javifercep/Krakoski/(threads)

Thread 1 (2015-12-20):

Correct USB connector footprint pinout

javifercep, 2015-12-20:
It is inverted

Thread 2 (2015-12-22):

Error in Arduino pinout footprint

javifercep, 2015-12-22:
The "ISP" connector is shifted 2,54 mm

Thread 3 (2015-12-22):

NRF024L01 footprint is inverted

javifercep, 2015-12-22:

Thread 4 (2015-12-28):

UART pins are inverted in schematic

javifercep, 2015-12-28:
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
