javifercep/Krakoski/Krakoski.kicad_pcb

## KiCad design Krakoski.kicad_pcb (2015-12-08)

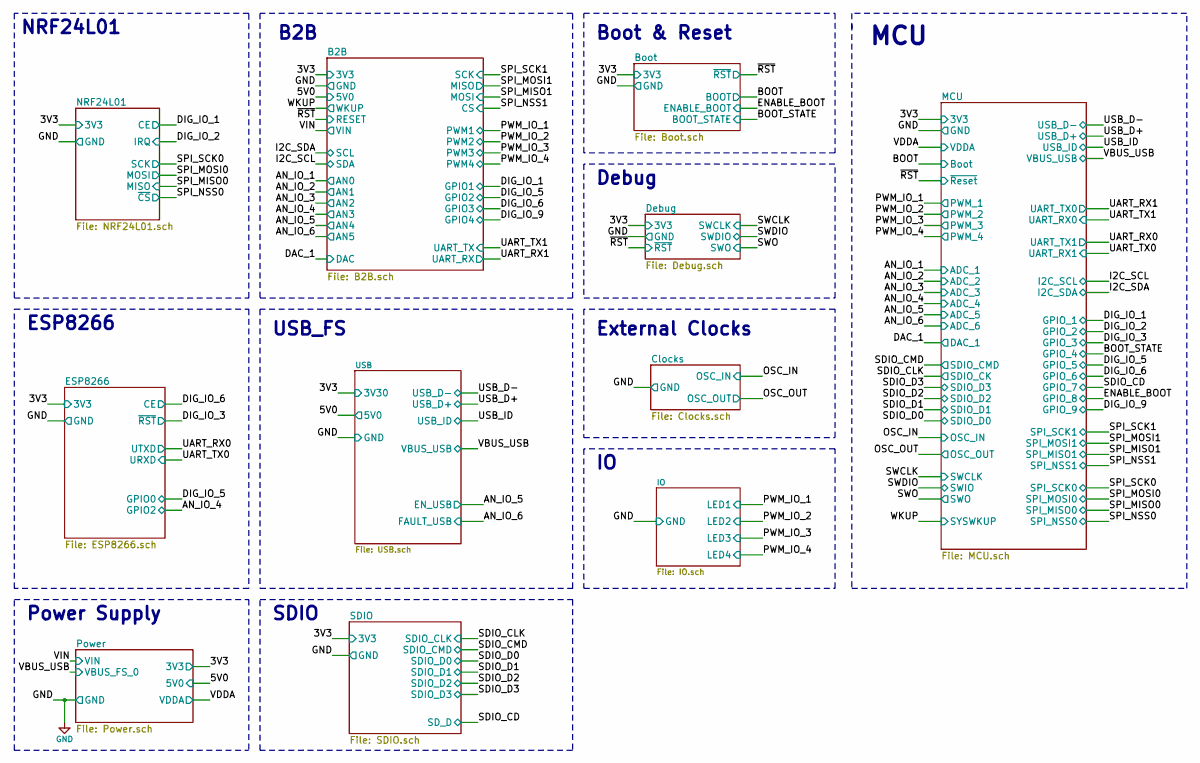
[picture p22: schematic Krakoski.sch]

Notes on the sheet:
Power Supply
USB_FS
Debug
External Clocks
MCU
Boot & Reset
ESP8266
B2B
NRF24L01
SDIO

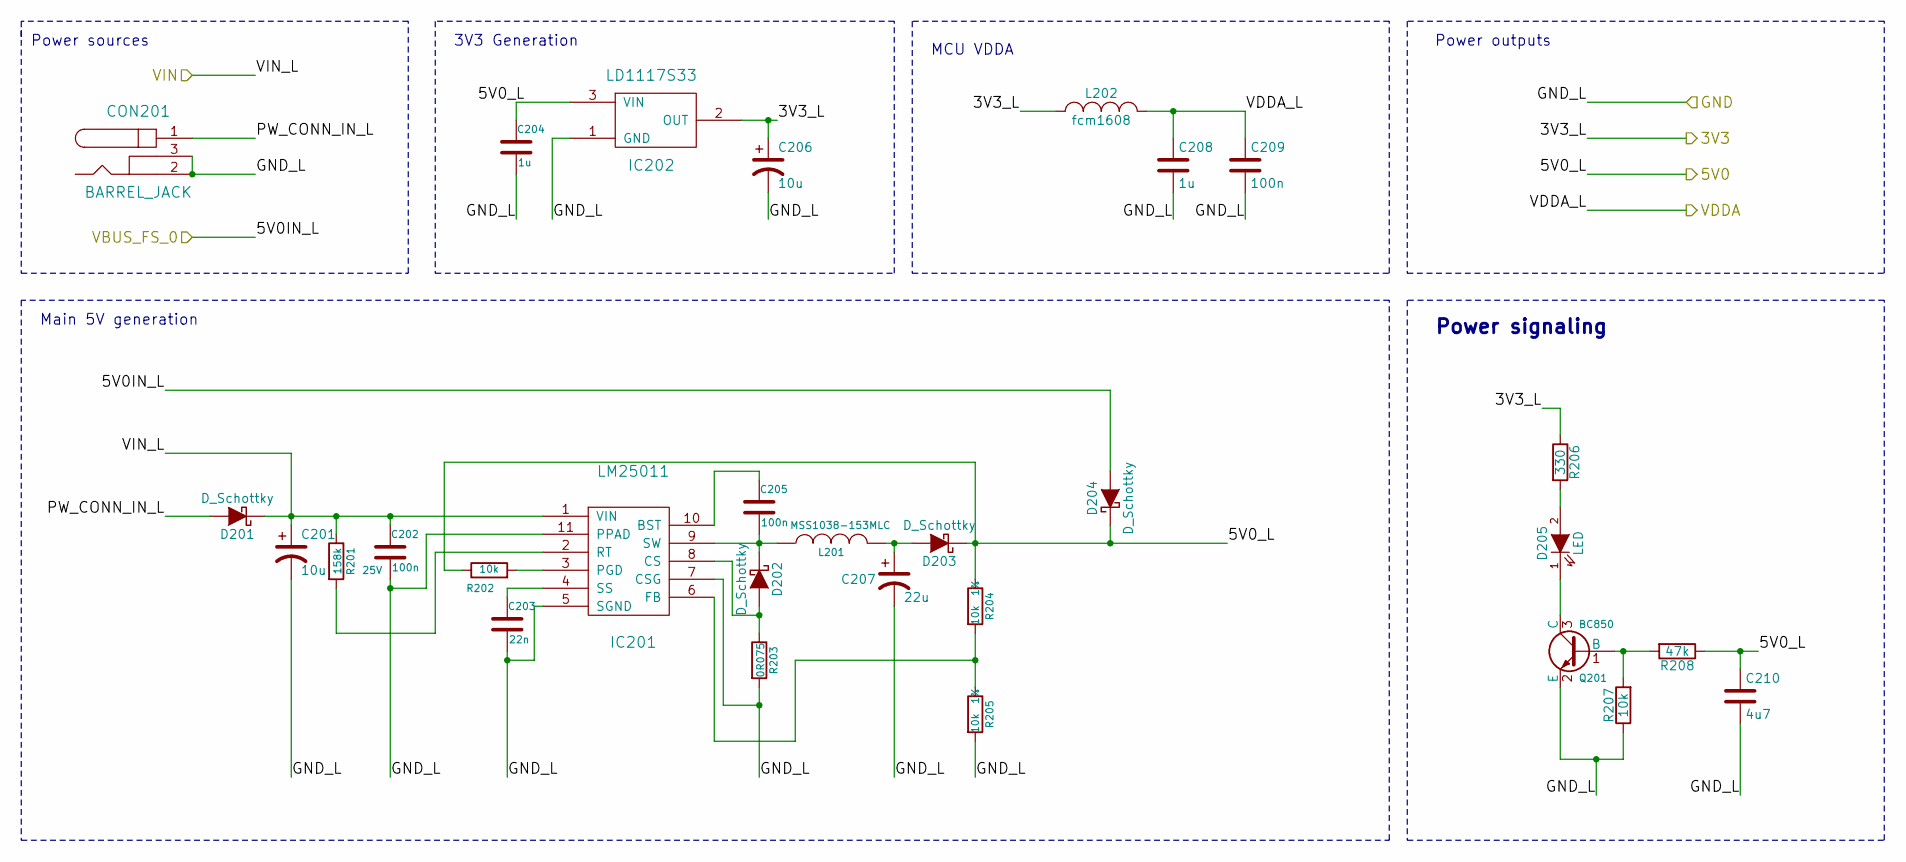
[picture p23: schematic Power.sch, Krakoski]

Parts:
C201: 10u; C_1206_HandSoldering
C202, C205: 100n; C_0805_HandSoldering
C203: 22n; C_0603_HandSoldering
C204, C208: 1u; C_0603_HandSoldering
C206: 10u; C_0603_HandSoldering
C207: 22u; C_1206_HandSoldering
C209: 100n; C_0603_HandSoldering
C210: 4u7; C_0805_HandSoldering
CON201: BARREL_JACK; JACK_ALIM_MOD
D201, D202, D203: D_Schottky; SMA_Handsoldering
D204: D_Schottky; SOD-123
D205: LED; LED-0805
IC201: LM25011; VSSOP10
IC202: LD1117S33; SOT-223
L201: MSS1038-153MLC; MSS1038
L202: fcm1608; R_0603_HandSoldering
Q201: BC850; SOT-23_Handsoldering
R201: 158k; R_0603_HandSoldering
R202, R207: 10k; R_0603_HandSoldering
R203: 0R075; R_0805_HandSoldering
R204, R205: 10k; R_0603_HandSoldering; Tolerancia 1%
R206: 330; R_0603_HandSoldering
R208: 47k; R_0603_HandSoldering

Connections:
/B2B/3V3: C206.1, IC202.2 (OUT), L202.1, R206.1; also elsewhere on the board
/B2B/5V0: C204.1, C210.1, D203.1 (K), D204.1 (K), IC202.3 (VIN), R202.1, R204.1, R208.1; also elsewhere on the board
/B2B/VIN: C201.1, C202.1, D201.1 (K), IC201.1 (VIN), R201.1; also elsewhere on the board
/MCU/VDDA: C208.1, C209.1, L202.2; also elsewhere on the board
/Power/PW_CONN_IN_L: CON201.1, D201.2 (A)
/Power/VBUS_FS_0: D204.2 (A); also elsewhere on the board
GND: C201.2, C202.2, C203.2, C204.2, C206.2, C207.2, C208.2, C209.2, C210.2, CON201.2, CON201.3, IC201.5 (SGND), IC201.7 (CSG), IC201.11 (PPAD), IC202.1 (GND), Q201.2 (E), R203.2, R205.2, R207.1; also elsewhere on the board
unnamed: C203.1, IC201.4 (SS)
unnamed: C205.1, IC201.10 (BST)
unnamed: C205.2, D202.1 (K), IC201.9 (SW), L201.1
unnamed: C207.1, D203.2 (A), L201.2
unnamed: D202.2 (A), IC201.8 (CS), R203.1
unnamed: D205.1 (K), Q201.3 (C)
unnamed: D205.2 (A), R206.2
unnamed: IC201.2 (RT), R201.2
unnamed: IC201.3 (PGD), R202.2
unnamed: IC201.6 (FB), R204.2, R205.1
unnamed: Q201.1 (B), R207.2, R208.2

Notes on the sheet:
Power sources
Main 5V generation
3V3 Generation
Power outputs
Power signaling
MCU VDDA

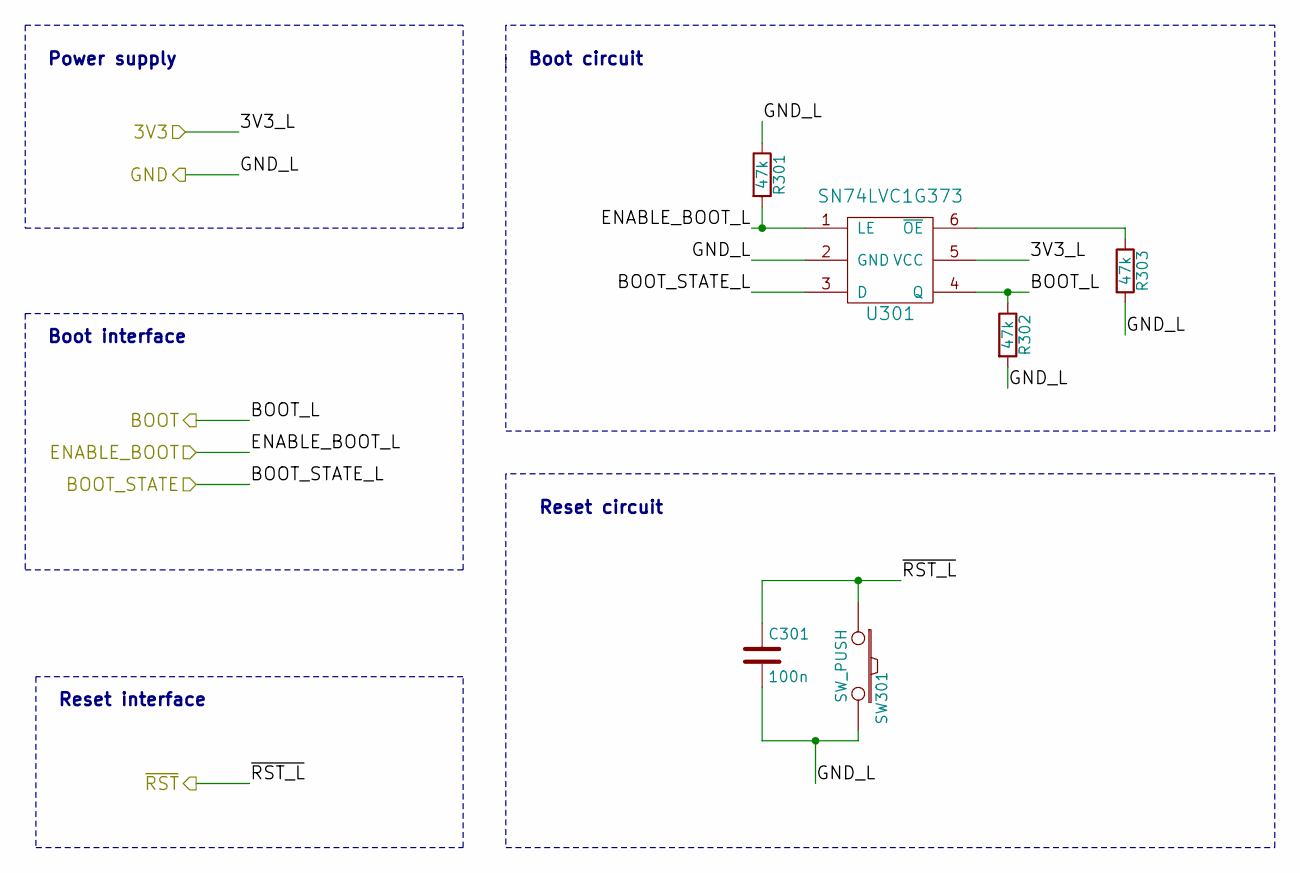
[picture p24: schematic Boot.sch, Krakoski]

Parts:
C301: 100n; C_0603_HandSoldering
R301, R302, R303: 47k; R_0603_HandSoldering
SW301: SW_PUSH; SW_PUSH_SMALL_SMD
U301: SN74LVC1G373; SOT-23-6

Connections:
/B2B/3V3: U301.5 (VCC); also elsewhere on the board
/B2B/RESET: C301.1, SW301.1; also elsewhere on the board
/Boot/BOOT: R302.1, U301.4 (Q); also elsewhere on the board
/Boot/BOOT_STATE: U301.3 (D); also elsewhere on the board
/Boot/ENABLE_BOOT: R301.2, U301.1 (LE); also elsewhere on the board
GND: C301.2, R301.1, R302.2, R303.2, SW301.2, U301.2 (GND); also elsewhere on the board
unnamed: R303.1, U301.6 (~OE)

Notes on the sheet:
Reset circuit
Boot circuit
Power supply
Boot interface
Reset interface

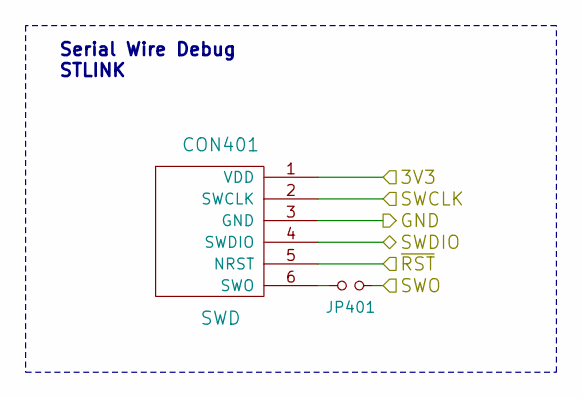
[picture p25: schematic Debug.sch, Krakoski]

Parts:
CON401: SWD; Pin_Header_Straight_1x06
JP401: Jumper_NO_Small; R_0603_HandSoldering

Connections:
/B2B/3V3: CON401.1 (VDD); also elsewhere on the board
/B2B/RESET: CON401.5 (NRST); also elsewhere on the board
/Debug/SWCLK: CON401.2 (SWCLK); also elsewhere on the board
/Debug/SWDIO: CON401.4 (SWDIO); also elsewhere on the board
/Debug/SWO: JP401.2; also elsewhere on the board
GND: CON401.3 (GND); also elsewhere on the board
unnamed: CON401.6 (SWO), JP401.1

Notes on the sheet:
Serial Wire Debug STLINK

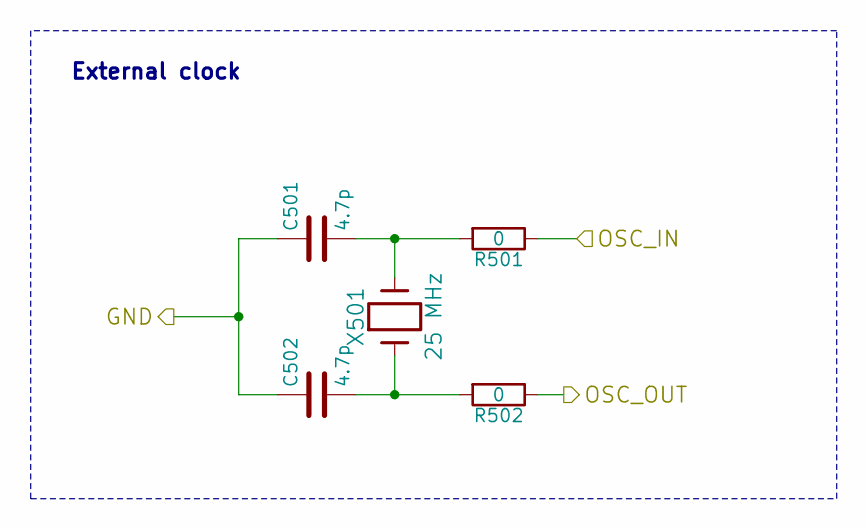
[picture p26: schematic Clocks.sch, Krakoski]

Parts:
C501, C502: 4.7p; C_0603_HandSoldering
R501, R502: 0; R_0603_HandSoldering
X501: 25 MHz; 7A-25.000MAAJ-T

Connections:
/Clocks/OSC_IN: R501.1; also elsewhere on the board
/Clocks/OSC_OUT: R502.1; also elsewhere on the board
GND: C501.1, C502.1; also elsewhere on the board
unnamed: C501.2, R501.2, X501.2
unnamed: C502.2, R502.2, X501.1

Notes on the sheet:
External clock

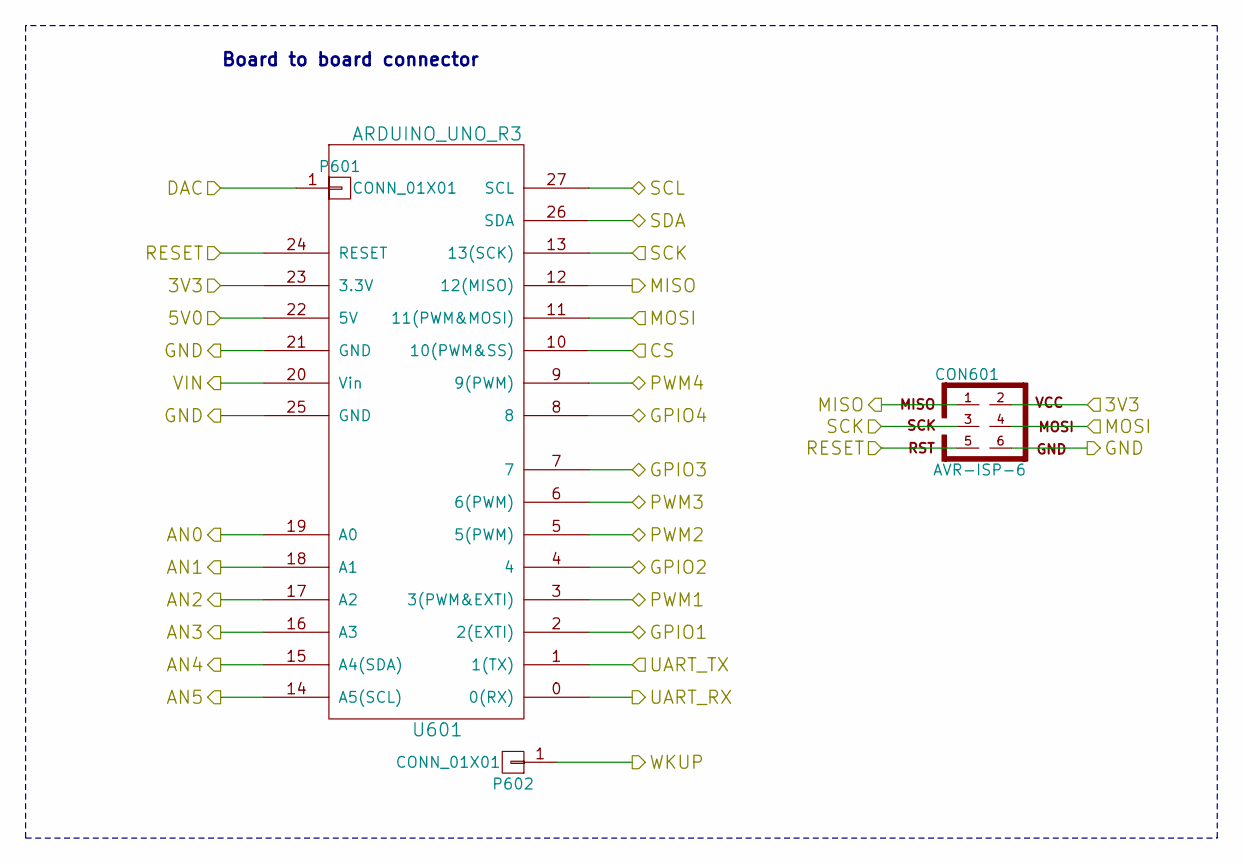
[picture p27: schematic B2B.sch, Krakoski]

Parts:
CON601: AVR-ISP-6; Pin_Header_Straight_2x03
P601, P602: CONN_01X01; Socket_Strip_Straight_1x01
U601: ARDUINO_UNO_R3; ArduinoUNOShieldR3

Connections:
/B2B/3V3: CON601.2, U601.23 (3.3V); also elsewhere on the board
/B2B/5V0: U601.22 (5V); also elsewhere on the board
/B2B/CS: U601.10 (10(PWM&SS)); also elsewhere on the board
/B2B/GPIO4: U601.8; also elsewhere on the board
/B2B/MISO: CON601.1, U601.12 (12(MISO)); also elsewhere on the board
/B2B/MOSI: CON601.4, U601.11 (11(PWM&MOSI)); also elsewhere on the board
/B2B/RESET: CON601.5, U601.24 (RESET); also elsewhere on the board
/B2B/SCK: CON601.3, U601.13 (13(SCK)); also elsewhere on the board
/B2B/UART_RX: U601.0 (0(RX)); also elsewhere on the board
/B2B/VIN: U601.20 (Vin); also elsewhere on the board
/ESP8266/CE: U601.7; also elsewhere on the board
/ESP8266/GPIO0: U601.4; also elsewhere on the board
/IO/LED1: U601.3 (3(PWM&EXTI)); also elsewhere on the board
/IO/LED2: U601.5 (5(PWM)); also elsewhere on the board
/IO/LED3: U601.6 (6(PWM)); also elsewhere on the board
/IO/LED4: U601.9 (9(PWM)); also elsewhere on the board
/MCU/ADC_1: U601.19 (A0); also elsewhere on the board
/MCU/ADC_2: U601.18 (A1); also elsewhere on the board
/MCU/ADC_3: U601.17 (A2); also elsewhere on the board
/MCU/ADC_4: U601.16 (A3); also elsewhere on the board
/MCU/ADC_5: U601.15 (A4(SDA)); also elsewhere on the board
/MCU/ADC_6: U601.14 (A5(SCL)); also elsewhere on the board
/MCU/I2C_SCL: U601.26 (SDA); also elsewhere on the board
/MCU/I2C_SDA: U601.27 (SCL); also elsewhere on the board
/MCU/UART_RX0: U601.1 (1(TX)); also elsewhere on the board
/NRF24L01/CE: U601.2 (2(EXTI)); also elsewhere on the board
GND: CON601.6, U601.21 (GND), U601.25 (GND); also elsewhere on the board

Notes on the sheet:
Board to board connector

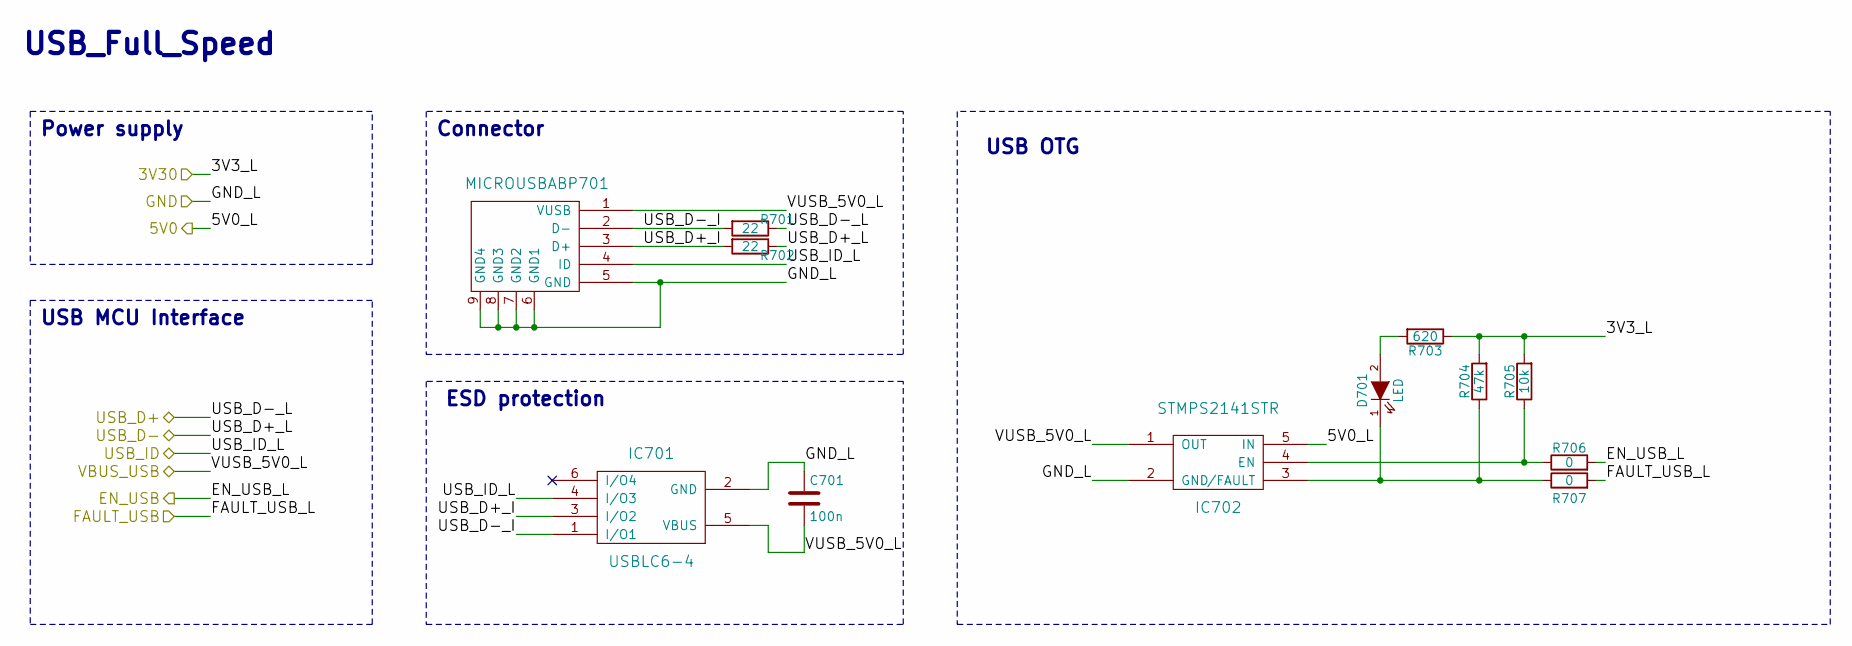
[picture p28: schematic USB.sch, Krakoski]

Parts:
C701: 100n; C_0603_HandSoldering
D701: LED; LED-0805
IC701: USBLC6-4; SOT-23-6
IC702: STMPS2141STR; SOT-23-5
P701: MICROUSBAB; uUSB-AB
R701, R702: 22; R_0603_HandSoldering
R703: 620; R_0603_HandSoldering
R704: 47k; R_0603_HandSoldering
R705: 10k; R_0603_HandSoldering
R706, R707: 0; R_0603_HandSoldering

Connections:
/B2B/3V3: R703.1, R704.2, R705.2; also elsewhere on the board
/B2B/5V0: IC702.5 (IN); also elsewhere on the board
/MCU/ADC_5: R706.2; also elsewhere on the board
/MCU/ADC_6: R707.2; also elsewhere on the board
/MCU/USB_D+: R701.1; also elsewhere on the board
/MCU/USB_D-: R702.1; also elsewhere on the board
/MCU/USB_ID: IC701.4 (I/O3), P701.4 (ID); also elsewhere on the board
/Power/VBUS_FS_0: C701.2, IC701.5 (VBUS), IC702.1 (OUT), P701.1 (VUSB); also elsewhere on the board
/USB/USB_D+_I: IC701.3 (I/O2), P701.3 (D+), R702.2
/USB/USB_D-_I: IC701.1 (I/O1), P701.2 (D-), R701.2
GND: C701.1, IC701.2 (GND), IC702.2 (GND), P701.5 (GND), P701.6 (GND1), P701.7 (GND2), P701.8 (GND3), P701.9 (GND4); also elsewhere on the board
unnamed: D701.1 (K), IC702.3 (/FAULT), R704.1, R707.1
unnamed: D701.2 (A), R703.2
unnamed: IC702.4 (EN), R705.1, R706.1

Notes on the sheet:
Power supply
USB_Full_Speed
Connector
ESD protection
USB MCU Interface
USB OTG

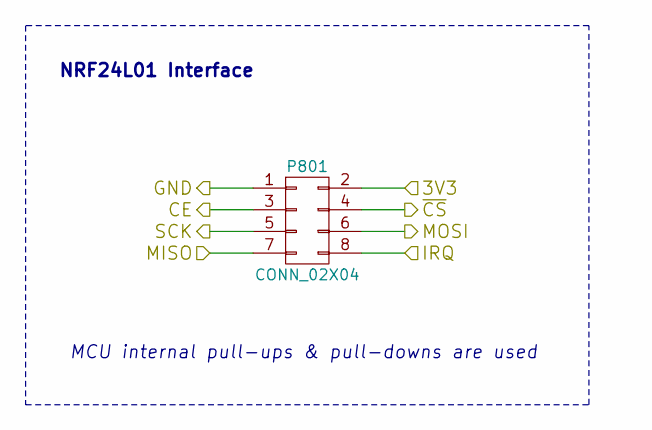
[picture p29: schematic NRF24L01.sch, Krakoski]

Parts:
P801: CONN_02X04; Socket_Strip_Straight_2x04

Connections:
/B2B/3V3: P801.2; also elsewhere on the board
/MCU/GPIO_2: P801.8; also elsewhere on the board
/MCU/SPI_NSS0: P801.4; also elsewhere on the board
/NRF24L01/CE: P801.3; also elsewhere on the board
/NRF24L01/MISO: P801.7; also elsewhere on the board
/NRF24L01/MOSI: P801.6; also elsewhere on the board
/NRF24L01/SCK: P801.5; also elsewhere on the board
GND: P801.1; also elsewhere on the board

Notes on the sheet:
MCU internal pull-ups & pull-downs are used
NRF24L01 Interface

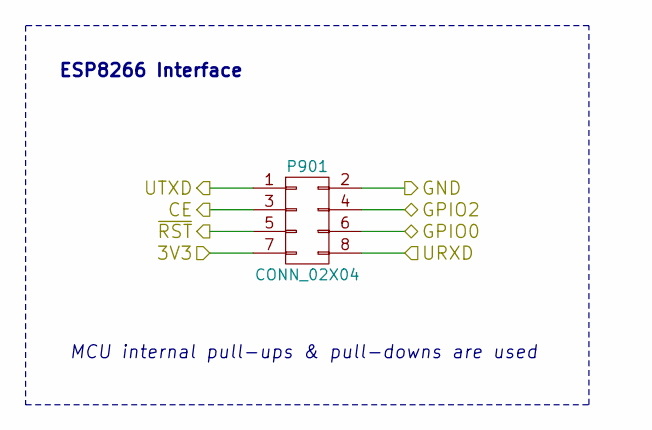
[picture p30: schematic ESP8266.sch, Krakoski]

Parts:
P901: CONN_02X04; Socket_Strip_Straight_2x04

Connections:
/B2B/3V3: P901.7; also elsewhere on the board
/ESP8266/CE: P901.3; also elsewhere on the board
/ESP8266/GPIO0: P901.6; also elsewhere on the board
/MCU/ADC_4: P901.4; also elsewhere on the board
/MCU/GPIO_3: P901.5; also elsewhere on the board
/MCU/UART_RX1: P901.8; also elsewhere on the board
/MCU/UART_TX1: P901.1; also elsewhere on the board
GND: P901.2; also elsewhere on the board

Notes on the sheet:
MCU internal pull-ups & pull-downs are used
ESP8266 Interface

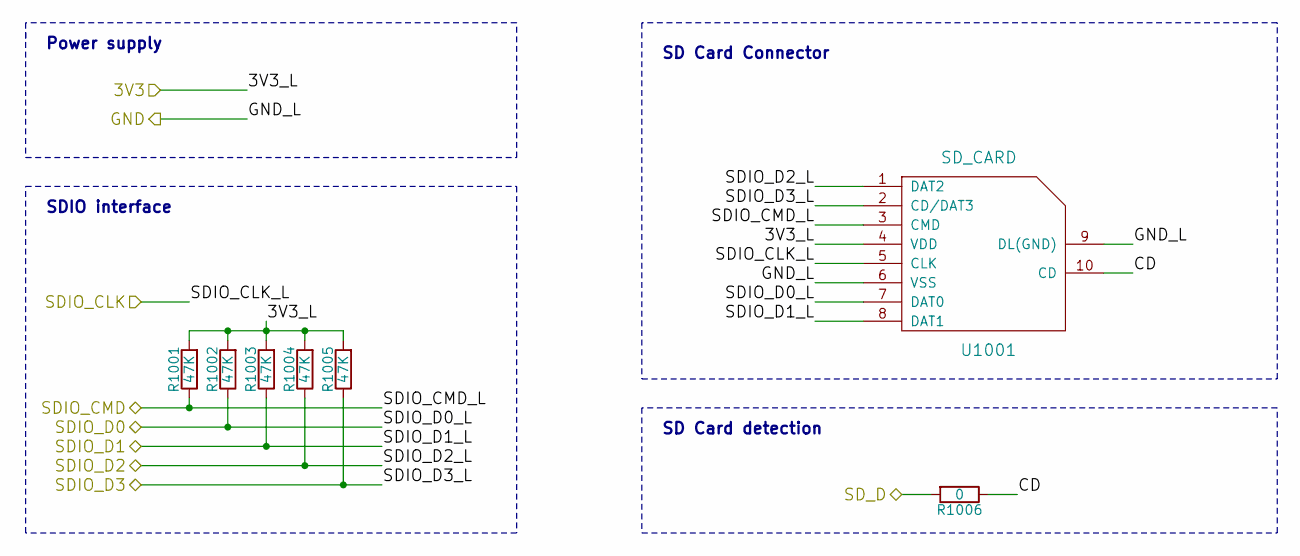
[picture p31: schematic SDIO.sch, Krakoski]

Parts:
R1001, R1002, R1003, R1004, R1005: 47K; R_0603_HandSoldering
R1006: 0; R_0603_HandSoldering
U1001: SD_CARD; uSDCard

Connections:
/B2B/3V3: R1001.2, R1002.2, R1003.2, R1004.2, R1005.2, U1001.4 (VDD); also elsewhere on the board
/MCU/GPIO_7: R1006.2; also elsewhere on the board
/MCU/SDIO_CK: U1001.5 (CLK); also elsewhere on the board
/MCU/SDIO_CMD: R1001.1, U1001.3 (CMD); also elsewhere on the board
/MCU/SDIO_D0: R1002.1, U1001.7 (DAT0); also elsewhere on the board
/MCU/SDIO_D1: R1003.1, U1001.8 (DAT1); also elsewhere on the board
/MCU/SDIO_D2: R1004.1, U1001.1 (DAT2); also elsewhere on the board
/MCU/SDIO_D3: R1005.1, U1001.2 (CD/DAT3); also elsewhere on the board
/SDIO/CD: R1006.1, U1001.10 (CD)
GND: U1001.6 (VSS), U1001.9 (DL(GND)); also elsewhere on the board

Notes on the sheet:
SD Card Connector
Power supply
SDIO interface
SD Card detection

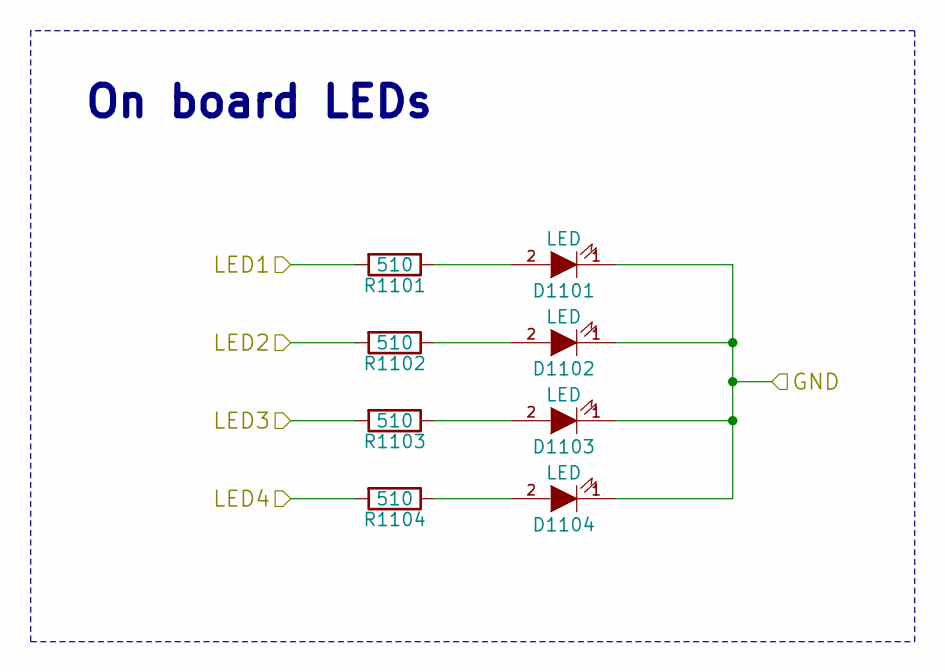
[picture p32: schematic IO.sch, Krakoski]

Parts:
D1101, D1102, D1103, D1104: LED; LED-0805
R1101, R1102, R1103, R1104: 510; R_0603_HandSoldering

Connections:
/IO/LED1: R1101.2; also elsewhere on the board
/IO/LED2: R1102.2; also elsewhere on the board
/IO/LED3: R1103.2; also elsewhere on the board
/IO/LED4: R1104.2; also elsewhere on the board
GND: D1101.1 (K), D1102.1 (K), D1103.1 (K), D1104.1 (K); also elsewhere on the board
unnamed: D1101.2 (A), R1101.1
unnamed: D1102.2 (A), R1102.1
unnamed: D1103.2 (A), R1103.1
unnamed: D1104.2 (A), R1104.1

Notes on the sheet:
On board LEDs

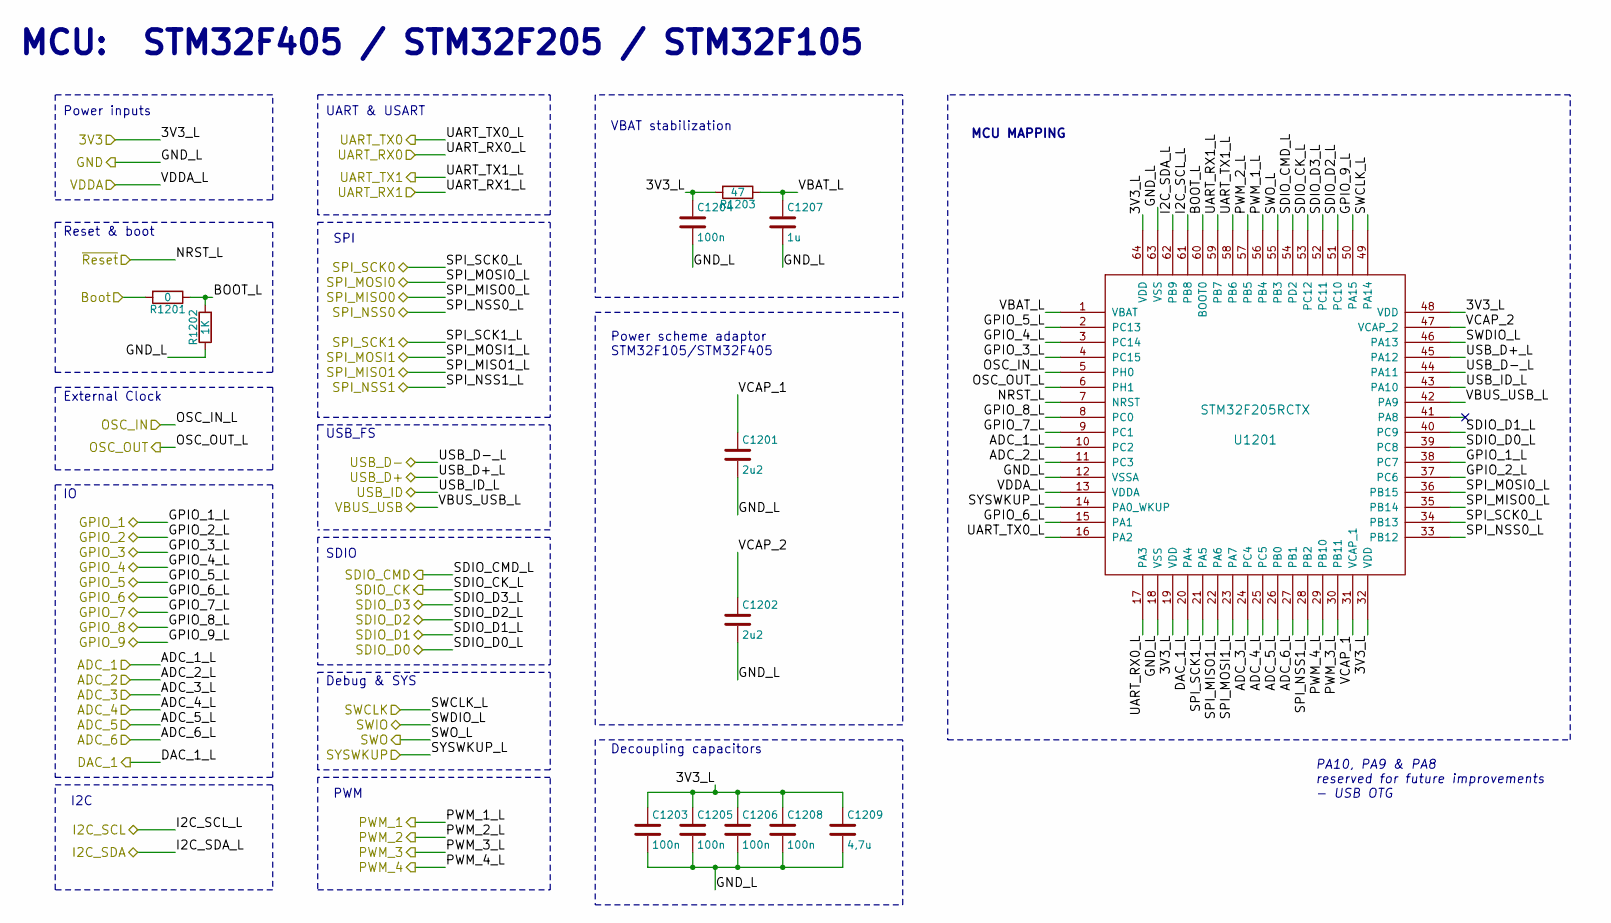
[picture p33: schematic MCU.sch, Krakoski]

Parts:
C1201, C1202: 2u2; C_0805_HandSoldering
C1203, C1204, C1205, C1206, C1208: 100n; C_0603_HandSoldering
C1207: 1u; C_0603_HandSoldering
C1209: 4,7u; C_0603_HandSoldering
R1201: 0; R_0603_HandSoldering
R1202: 1K; R_0603_HandSoldering
R1203: 47; R_0603_HandSoldering
U1201: STM32F205RCTX; LQFP-64_10x10mm_Pitch0.5mm

Connections:
/B2B/3V3: C1203.1, C1204.1, C1205.1, C1206.1, C1208.1, C1209.1, R1203.2, U1201.19 (VDD), U1201.32 (VDD), U1201.48 (VDD), U1201.64 (VDD); also elsewhere on the board
/B2B/CS: U1201.28 (PB2); also elsewhere on the board
/B2B/DAC: U1201.20 (PA4); also elsewhere on the board
/B2B/GPIO4: U1201.50 (PA15); also elsewhere on the board
/B2B/MISO: U1201.23 (PA7); also elsewhere on the board
/B2B/MOSI: U1201.22 (PA6); also elsewhere on the board
/B2B/RESET: U1201.7 (NRST); also elsewhere on the board
/B2B/SCK: U1201.21 (PA5); also elsewhere on the board
/B2B/UART_RX: U1201.16 (PA2); also elsewhere on the board
/Boot/BOOT: R1201.2; also elsewhere on the board
/Boot/BOOT_STATE: U1201.3 (PC14); also elsewhere on the board
/Boot/ENABLE_BOOT: U1201.8 (PC0); also elsewhere on the board
/Clocks/OSC_IN: U1201.5 (PH0); also elsewhere on the board
/Clocks/OSC_OUT: U1201.6 (PH1); also elsewhere on the board
/Debug/SWCLK: U1201.49 (PA14); also elsewhere on the board
/Debug/SWDIO: U1201.46 (PA13); also elsewhere on the board
/Debug/SWO: U1201.55 (PB3); also elsewhere on the board
/ESP8266/CE: U1201.15 (PA1); also elsewhere on the board
/ESP8266/GPIO0: U1201.2 (PC13); also elsewhere on the board
/IO/LED1: U1201.56 (PB4); also elsewhere on the board
/IO/LED2: U1201.57 (PB5); also elsewhere on the board
/IO/LED3: U1201.30 (PB11); also elsewhere on the board
/IO/LED4: U1201.29 (PB10); also elsewhere on the board
/MCU/ADC_1: U1201.10 (PC2); also elsewhere on the board
/MCU/ADC_2: U1201.11 (PC3); also elsewhere on the board
/MCU/ADC_3: U1201.24 (PC4); also elsewhere on the board
/MCU/ADC_4: U1201.25 (PC5); also elsewhere on the board
/MCU/ADC_5: U1201.26 (PB0); also elsewhere on the board
/MCU/ADC_6: U1201.27 (PB1); also elsewhere on the board
/MCU/BOOT_L: R1201.1, R1202.2, U1201.60 (BOOT0)
/MCU/GPIO_2: U1201.37 (PC6); also elsewhere on the board
/MCU/GPIO_3: U1201.4 (PC15); also elsewhere on the board
/MCU/GPIO_7: U1201.9 (PC1); also elsewhere on the board
/MCU/I2C_SCL: U1201.61 (PB8); also elsewhere on the board
/MCU/I2C_SDA: U1201.62 (PB9); also elsewhere on the board
/MCU/SDIO_CK: U1201.53 (PC12); also elsewhere on the board
/MCU/SDIO_CMD: U1201.54 (PD2); also elsewhere on the board
/MCU/SDIO_D0: U1201.39 (PC8); also elsewhere on the board
/MCU/SDIO_D1: U1201.40 (PC9); also elsewhere on the board
/MCU/SDIO_D2: U1201.51 (PC10); also elsewhere on the board
/MCU/SDIO_D3: U1201.52 (PC11); also elsewhere on the board
/MCU/SPI_NSS0: U1201.33 (PB12); also elsewhere on the board
/MCU/SYSWKUP: U1201.14 (PA0_WKUP); also elsewhere on the board
/MCU/UART_RX0: U1201.17 (PA3); also elsewhere on the board
/MCU/UART_RX1: U1201.59 (PB7); also elsewhere on the board
/MCU/UART_TX1: U1201.58 (PB6); also elsewhere on the board
/MCU/USB_D+: U1201.45 (PA12); also elsewhere on the board
/MCU/USB_D-: U1201.44 (PA11); also elsewhere on the board
/MCU/USB_ID: U1201.43 (PA10); also elsewhere on the board
/MCU/VBAT_L: C1207.1, R1203.1, U1201.1 (VBAT)
/MCU/VCAP_1: C1201.1, U1201.31 (VCAP_1)
/MCU/VCAP_2: C1202.1, U1201.47 (VCAP_2)
/MCU/VDDA: U1201.13 (VDDA); also elsewhere on the board
/NRF24L01/CE: U1201.38 (PC7); also elsewhere on the board
/NRF24L01/MISO: U1201.35 (PB14); also elsewhere on the board
/NRF24L01/MOSI: U1201.36 (PB15); also elsewhere on the board
/NRF24L01/SCK: U1201.34 (PB13); also elsewhere on the board
/Power/VBUS_FS_0: U1201.42 (PA9); also elsewhere on the board
GND: C1201.2, C1202.2, C1203.2, C1204.2, C1205.2, C1206.2, C1207.2, C1208.2, C1209.2, R1202.1, U1201.12 (VSSA), U1201.18 (VSS), U1201.63 (VSS); also elsewhere on the board

Notes on the sheet:
MCU: STM32F405 / STM32F205 / STM32F105
Power inputs
Decoupling capacitors
Reset & boot
External Clock
USB_FS
Debug & SYS
UART & USART
SPI
I2C
MCU MAPPING
Power scheme adaptor STM32F105/STM32F405
VBAT stabilization
PA10, PA9 & PA8 reserved for future improvements - USB OTG
PWM
SDIO

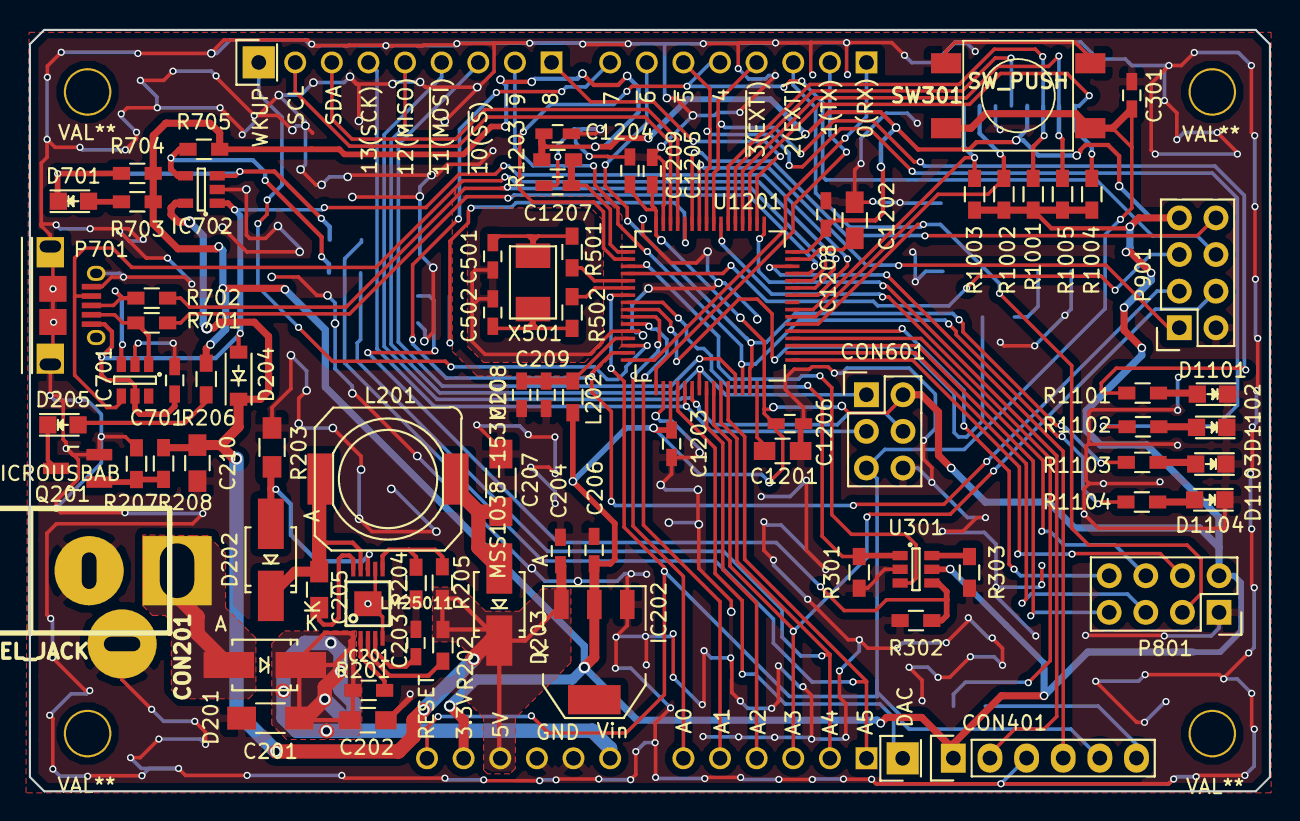
[picture p34: board Krakoski.kicad_pcb from above]

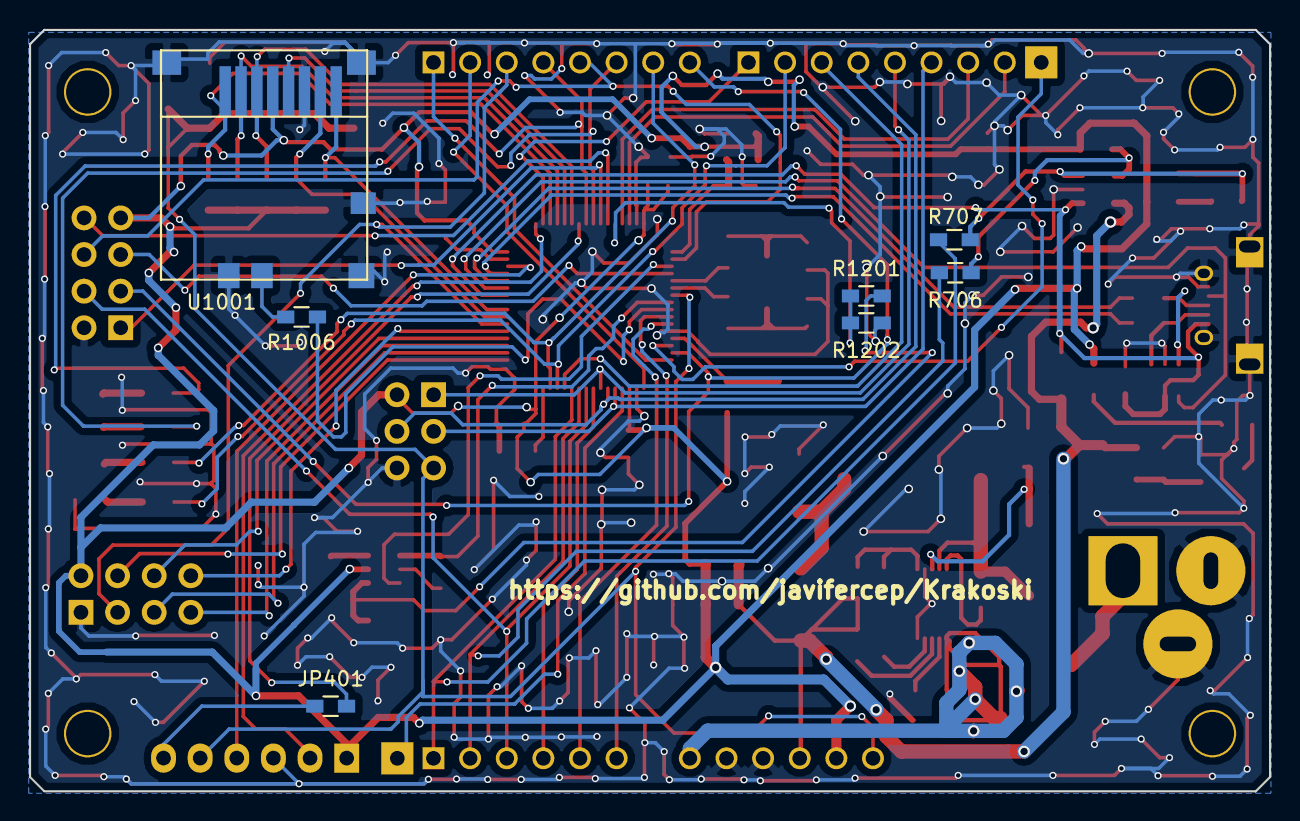
[picture p35: board Krakoski.kicad_pcb from below]

Board: 2 copper layers, 86.0 x 52.8 mm, 92 parts (7 on the bottom side), 87 nets.

Other parts of the board:
3MMDRILL, 3MMDRILL#2, 3MMDRILL#3, 3MMDRILL#4: VAL**; 3MMDRILL
DAC: CONN_01X01; Socket_Strip_Straight_1x01
WKUP: CONN_01X01; Socket_Strip_Straight_1x01

Their connections:
/B2B/DAC: DAC.1; also elsewhere on the board
/MCU/SYSWKUP: WKUP.1; also elsewhere on the board
