javifercep/Krakoski/(commit log)

2015-12-01 First krakoski output.
    [B2B.sch, Boot.sch, CAN.sch, Clocks.sch, Debug.sch, ESP8266.sch, IO.sch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]
2015-12-08 Release 1.0.0
    [B2B.sch, Boot.sch, Clocks.sch, Debug.sch, ESP8266.sch, IO.sch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]
